Yatekii/projekt5/documentation/report/main.tex

\documentclass{fhnwreport} %
\usepackage[ngerman]{babel}
\usepackage[T1]{fontenc}
\usepackage[utf8x]{inputenc}
\usepackage{tikz}
\usepackage{amsmath}
\usetikzlibrary{arrows}
\usepackage{lmodern}      % Type1-Schriftart für nicht-englische Texte
\usepackage{float}
\usetikzlibrary{shapes}
\usetikzlibrary{intersections}
\usepackage{circuitikz}
\usepackage{transparent}
\usepackage{graphicx}
\usepackage{caption}
\usepackage{subcaption}
\usepackage[toc,page]{appendix}
\usepackage{pdfpages}
\usepackage{siunitx}
\usepackage{mathtools,amssymb}

%%% IEEE-Style Bibliographie
\bibliographystyle{IEEEtran}

%% Und wenn die Bibliographie im Inhaltsverzeichnis sein soll:
\usepackage[nottoc]{tocbibind}

\title{%
  Projekt 5\\[2ex]
  Software Defined Radio}
\author{%
  Noah Hüsser und Francesco Rovelli}

\begin{document}

% Titel
\maketitle

\vfill

% Titelbild
% (kann man natürlich auch mit Includegraphics machen)
\begin{minipage}{\textwidth}
\begin{center}
\vspace*{5ex}
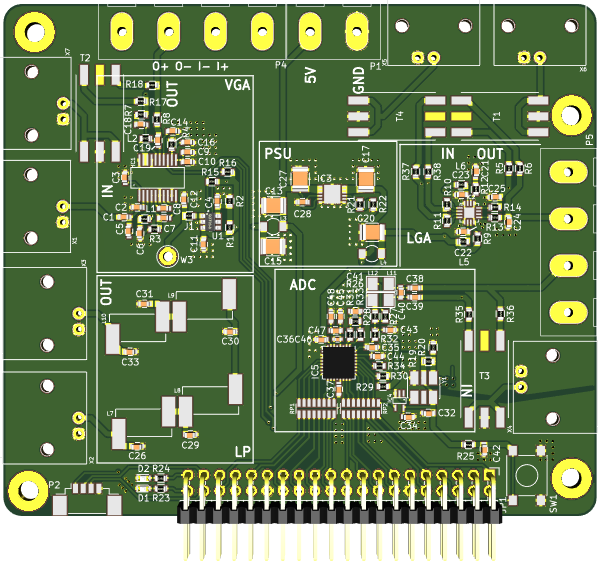
[picture p1: documentation/report/data/images/title.png]
    
\end{center}
\end{minipage}

\vfill

\begin{tabbing}
Auftraggeber: \hspace{2em} \=  Prof. Dr. Markus Hufschmid \\[2ex]
Betreuer:  \>  Prof. Dr. Markus Hufschmid \\[2ex]
Team:  \> Noah Hüsser \\ 
\> Francesco Rovelli \\[2ex]
Studiengang: \> Elektro- und Informationstechnik
\end{tabbing}

\hbox{}

\clearpage

\abstract{Analoge Frontends für Software Defined Radios sind für die Aufbereitung des analogen Signals zuständig und müssen einer Vielzahl von Anforderungen genügen. Dieses Projekt ist die Fortsetzung des 'Software Defined Radio mit FPGA'-Projekts und beschäftigt sich mit der Optimierung des AFE eines vorgängig existierenden Prototypen. Der Fokus liegt auf  der Filterung und der Verstärkung des Eingangssignals. Durch Anwendung von Techniken aus der Analogtechnik im Platinendesign und bei der Optimierung der Schaltung konnte eine überarbeitete Version entwickelt werden. Anschliessend durchgeführte Messungen bestätigen Verbesserungen in der analogen Signalverarbeitung, allerdings konnte die Aufgabenstellung in den Bereichen Rauschen und Digital-Analog-Wandlung nicht ganz abschliessend bearbeitet werden.}
\clearpage

\tableofcontents
\clearpage

\section{Einleitung}
\label{sec:motivation}
\label{sec:einleitung}
\input{sections/einleitung}

\clearpage

\section{Theorie}
\label{sec:sdr}
\input{sections/sdr}

\clearpage

\section{Ausgangslage}
\label{sec:ausgangslage}
\input{sections/ausgangslage}

\clearpage

\section{Design des Analogen Frontends}
\label{sec:afe}
\input{sections/afe}
\newpage
\subsection{Eingangsfilter}
\label{sec:filter}
\input{sections/filter}

\clearpage

\section{Messungen}
\label{sec:messungen}
\input{sections/messungen}

\clearpage

\section{Resultate}
\label{sec:resultate}
\input{sections/resultate}

\clearpage

\section{Diskussion}
\label{sec:diskussion}
\input{sections/diskussion}

\clearpage
\begin{appendices}

\subsection{Schaltplan}
\subsection{Layout}
\subsection{Stückliste}
\subsection{Projektplan}
\subsection{Projektauftrag}
\subsection{CD}

Die beigelegte CD beinhaltet das Git-Repository, welches folgende Dokumente beinhaltet:
  \begin{itemize}
    \item Schaltpläne\\
    \item Layout\\
    \item Python-Scripts\\
    \item Arduino-Source\\
    \item Datasheets\\
    \item Dieses Dokument
  \end{itemize}
\includepdf[pages=1,fitpaper]{data/images/amplifier}

\begin{figure}[H]
\begin{center}
  
  \caption{Top Layout.}
  \label{fig:top}
\end{center}
\end{figure}

\begin{figure}[H]
\begin{center}
  
  \caption{Bottom Layout.}
  \label{fig:bot}
\end{center}
\end{figure}

\includepdf[pages=1,fitpaper]{../../management/bom-prototype}

\includepdf[pages={1},fitpaper]{../../management/tasks}

\includepdf[pages={1,2,3,4},fitpaper]{../../management/Aufgabenstellung_SDR}

\end{appendices}

\clearpage
\bibliography{main,example,IEEEabrv}

\clearpage
\listoffigures

\end{document}
