Yatekii/projekt5/math/input_Z_A8331.png

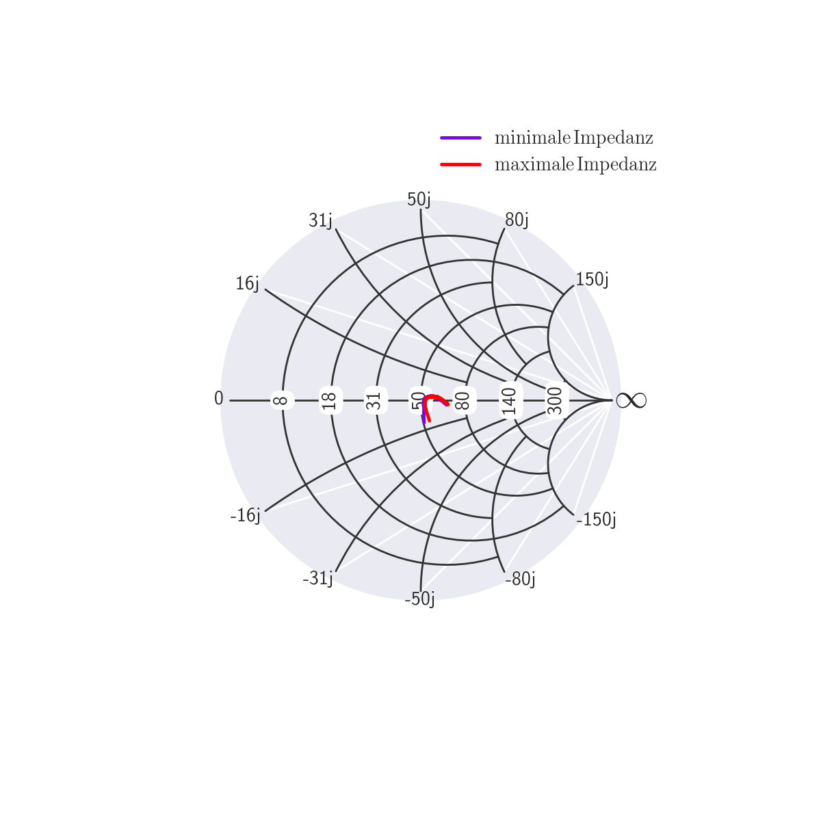
math/input_Z_A8331.png
