Yatekii/projekt5/math/vga_2016-12-16_30dBm_transmission.png

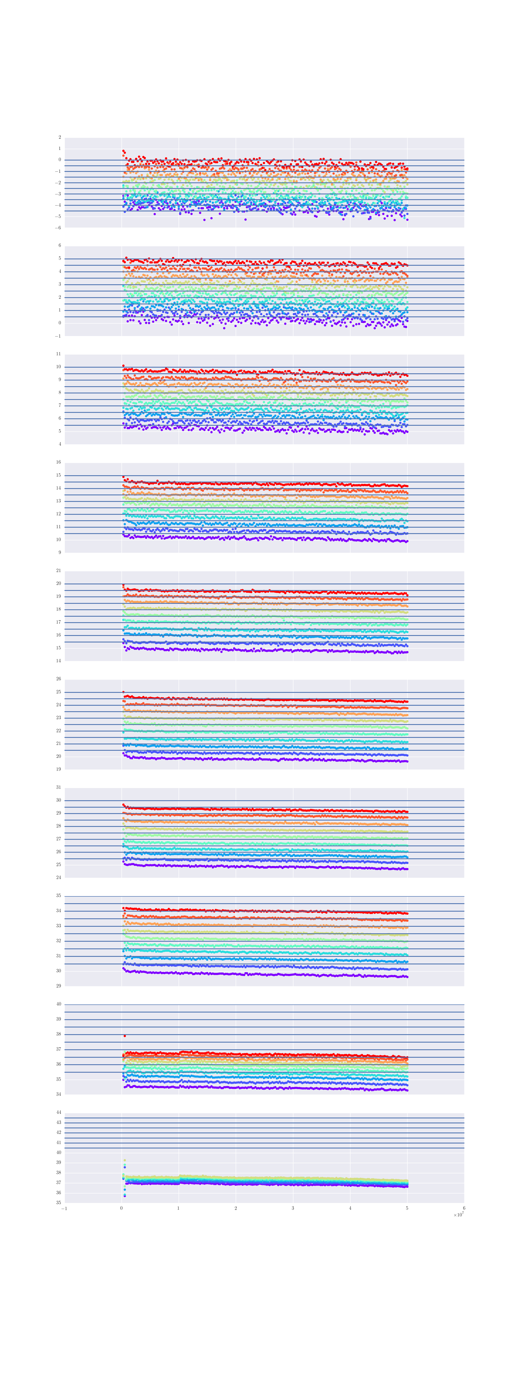
math/vga_2016-12-16_30dBm_transmission.png
