Yatekii/projekt5/math/vga_2016-12-16_40dBm_LNA_transmission.png

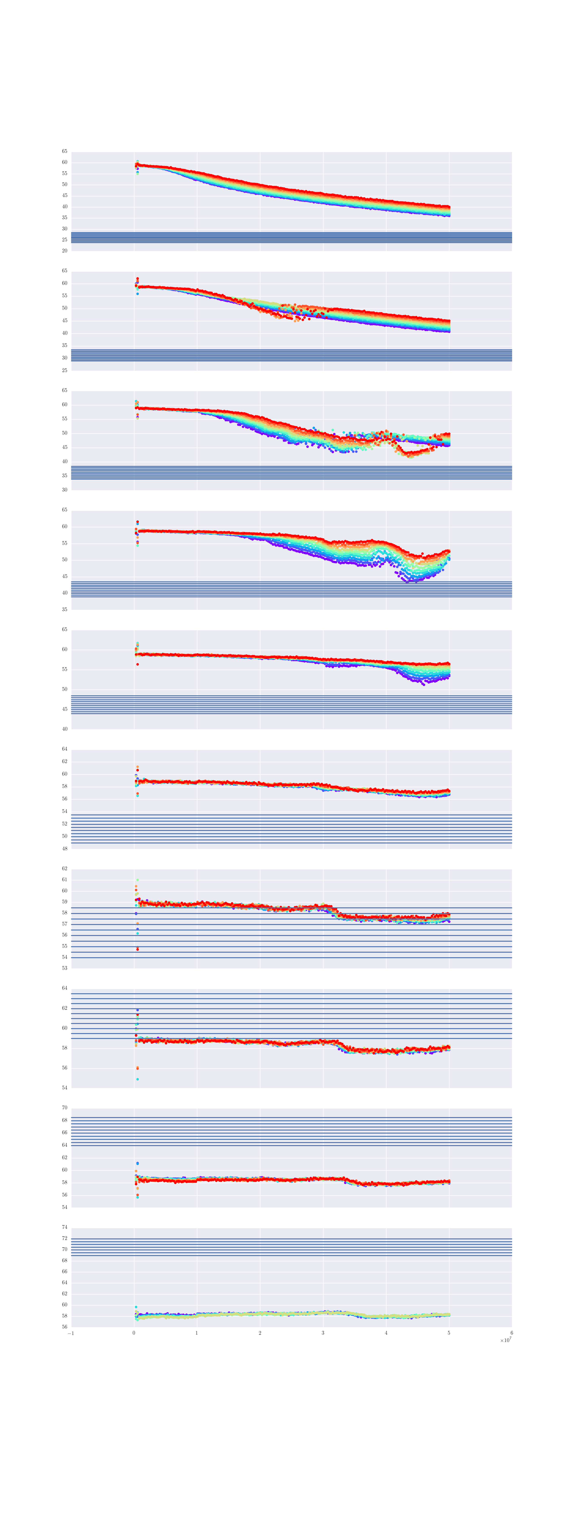
math/vga_2016-12-16_40dBm_LNA_transmission.png
