Yatekii/projekt5/math/vga_2016-12-19_40dBm_20kP_transmission.png

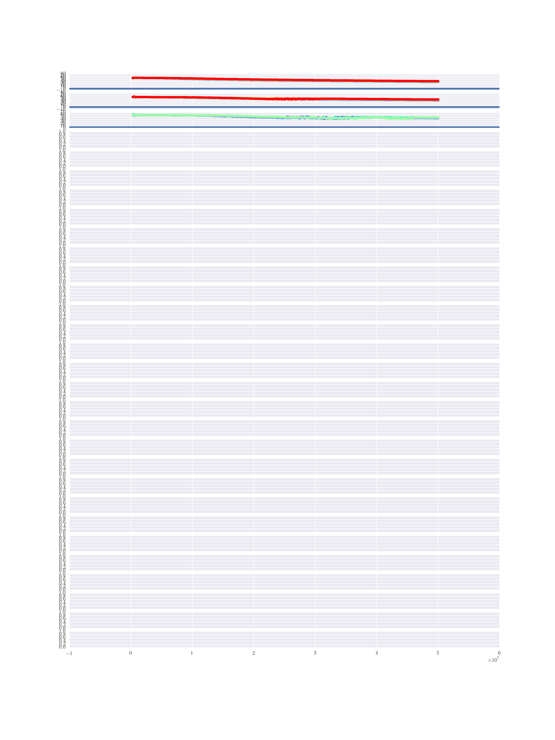
math/vga_2016-12-19_40dBm_20kP_transmission.png
