Yatekii/projekt5/math/vga_2016-12-22_50dBm_LNA_20dB_3_transmission.png

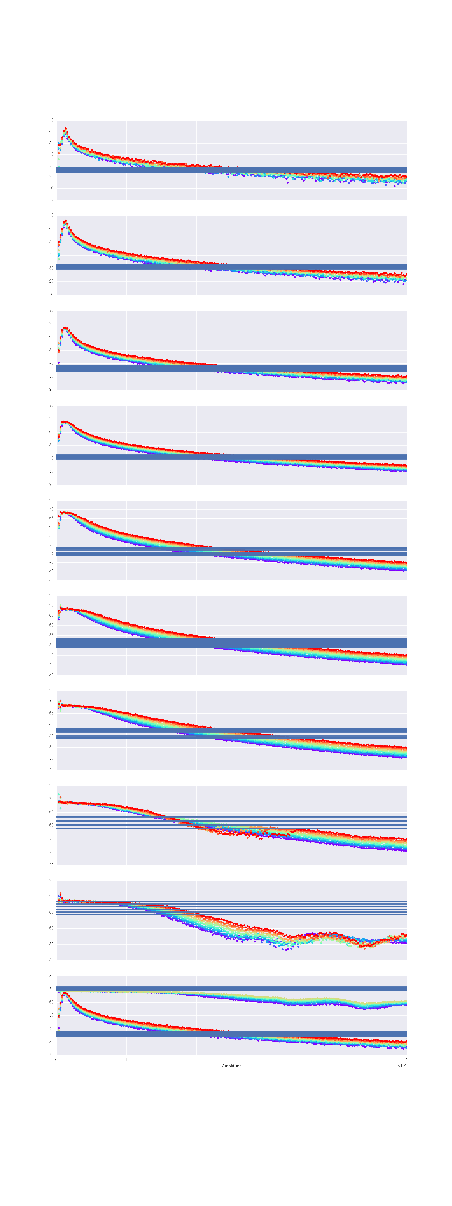
math/vga_2016-12-22_50dBm_LNA_20dB_3_transmission.png
