Yatekii/projekt5/math/vga_2016-12-22_50dBm_LNA_transmission2.png

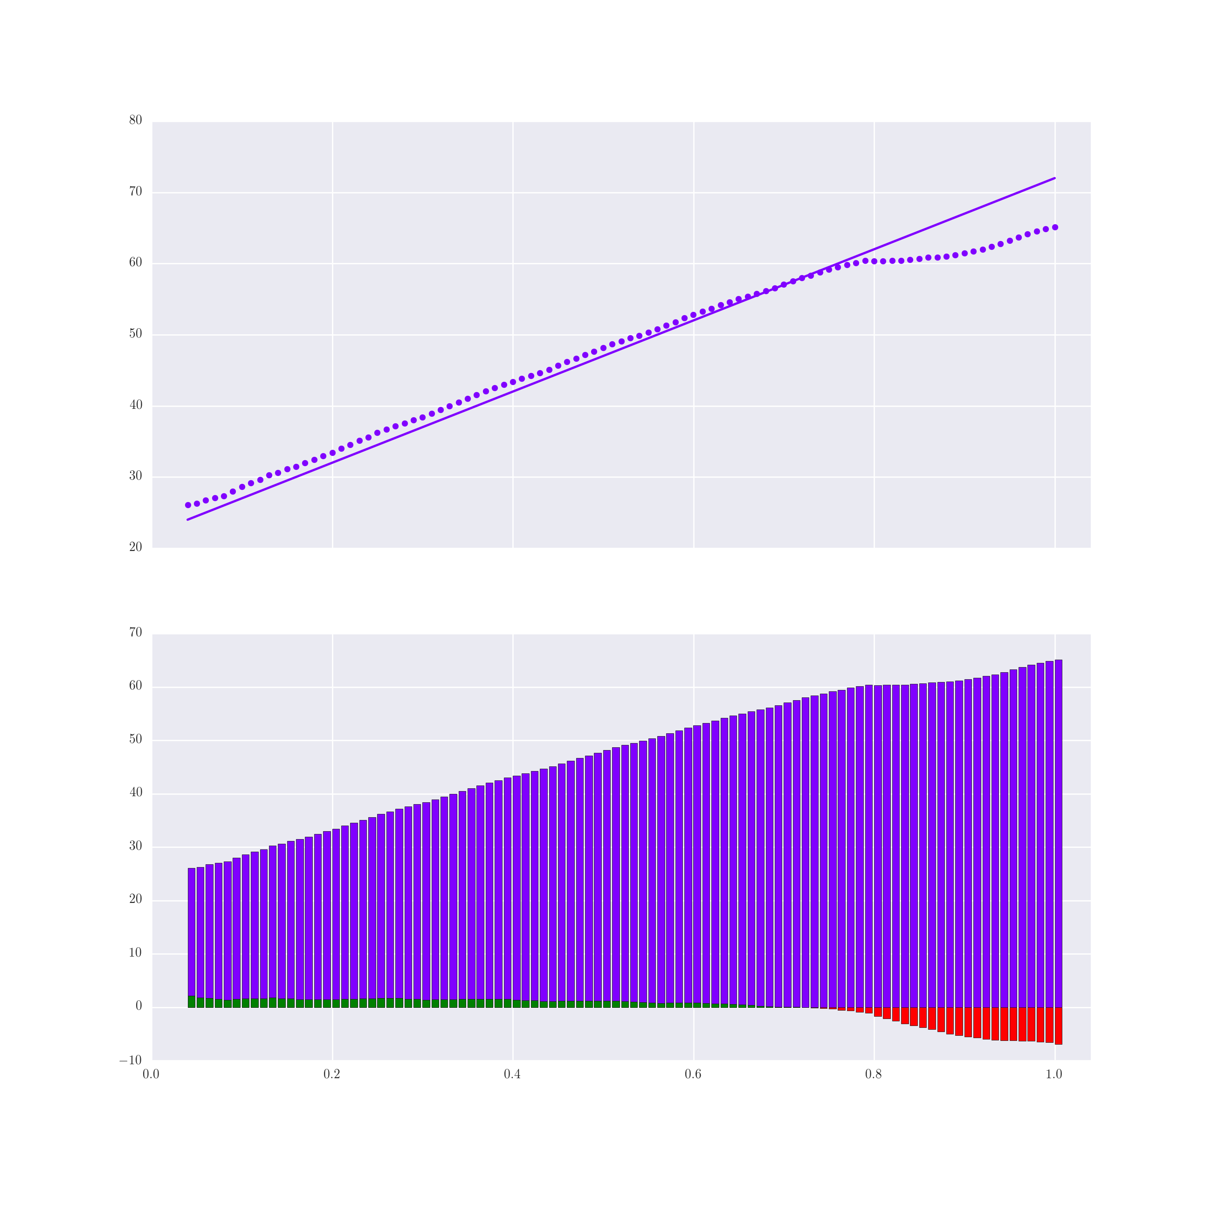
math/vga_2016-12-22_50dBm_LNA_transmission2.png
