Yatekii/projekt5/math/vga_lna_2016-01-18_50dBm_20dB_HI_rez.png

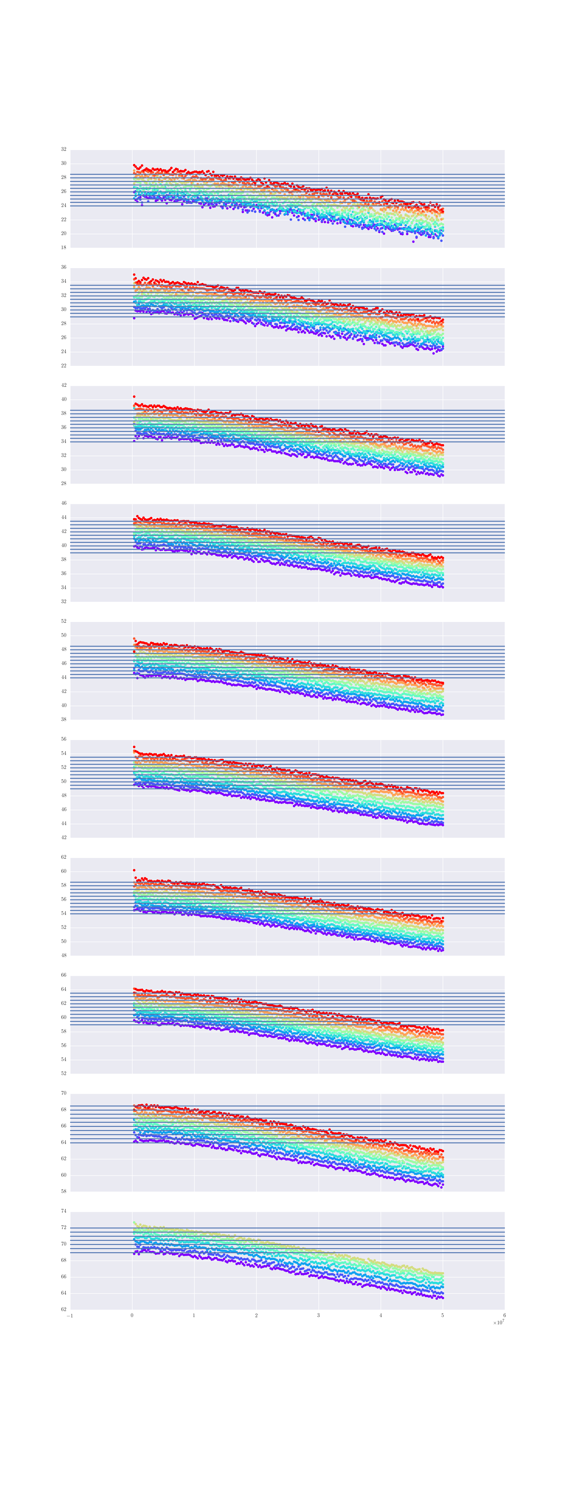
math/vga_lna_2016-01-18_50dBm_20dB_HI_rez.png
