Yatekii/projekt5/management/partslist.txt

4 380nH 2%
4 307nH 2%
7 8.2pF 0603
10 150pF 0603
10 2.2pF 0603
2 22uF 1206
6 100pF 0603
7 15pF 0603
8 10pF 0603
4 100nF 0603
4 1uF 0603
7 18nF 0603
4 82pF 0603
8 22pF 0603
6 180pF 0603
7 10nF 0603
10 Shottky 568-3420-1-ND
2 390nH 490-5698-1-ND
2 22uH 587-1626-1-ND
