Yatekii/projekt5/hardware/documentation/simulation/pifilter/result.txt

1.00000000000000e+000,-1.91051972765979e-003,-3.24650165658417e-004
1.00230523807790e+000,-1.91051896223974e-003,-3.25398561625838e-004
1.00461579027840e+000,-1.91051819328080e-003,-3.26148682794382e-004
1.00693166885180e+000,-1.91051742079550e-003,-3.26900533180799e-004
1.00925288607668e+000,-1.91051664474334e-003,-3.27654116759734e-004
1.01157945425990e+000,-1.91051586510405e-003,-3.28409437533248e-004
1.01391138573668e+000,-1.91051508184678e-003,-3.29166499454556e-004
1.01624869287070e+000,-1.91051429499177e-003,-3.29925306618255e-004
1.01859138805412e+000,-1.91051350448501e-003,-3.30685863056999e-004
1.02093948370768e+000,-1.91051271036702e-003,-3.31448172722033e-004
1.02329299228075e+000,-1.91051191255002e-003,-3.32212239686525e-004
1.02565192625141e+000,-1.91051111106970e-003,-3.32978068033185e-004
1.02801629812647e+000,-1.91051030587011e-003,-3.33745661771645e-004
1.03038612044162e+000,-1.91050949700335e-003,-3.34515024977873e-004
1.03276140576140e+000,-1.91050868435848e-003,-3.35286161776684e-004
1.03514216667934e+000,-1.91050786797216e-003,-3.36059076250408e-004
1.03752841581801e+000,-1.91050704780485e-003,-3.36833772429352e-004
1.03992016582906e+000,-1.91050622386426e-003,-3.37610254493155e-004
1.04231742939330e+000,-1.91050539611663e-003,-3.38388526548381e-004
1.04472021922080e+000,-1.91050456453400e-003,-3.39168592698034e-004
1.04712854805090e+000,-1.91050372916361e-003,-3.39950457027247e-004
1.04954242865232e+000,-1.91050288989745e-003,-3.40734123796689e-004
1.05196187382322e+000,-1.91050204678278e-003,-3.41519597104215e-004
1.05438689639126e+000,-1.91050119973761e-003,-3.42306881151729e-004
1.05681750921366e+000,-1.91050034879859e-003,-3.43095979991423e-004
1.05925372517729e+000,-1.91049949394258e-003,-3.43886897924101e-004
1.06169555719872e+000,-1.91049863513677e-003,-3.44679639149698e-004
1.06414301822431e+000,-1.91049777237732e-003,-3.45474207767283e-004
1.06659612123026e+000,-1.91049690559092e-003,-3.46270608124534e-004
1.06905487922266e+000,-1.91049603485473e-003,-3.47068844334830e-004
1.07151930523761e+000,-1.91049516008676e-003,-3.47868920683907e-004
1.07398941234124e+000,-1.91049428126772e-003,-3.48670841395555e-004
1.07646521362983e+000,-1.91049339839280e-003,-3.49474610696745e-004
1.07894672222983e+000,-1.91049251143112e-003,-3.50280232942729e-004
1.08143395129794e+000,-1.91049162041452e-003,-3.51087712252868e-004
1.08392691402120e+000,-1.91049072527162e-003,-3.51897053071775e-004
1.08642562361706e+000,-1.91048982597445e-003,-3.52708259580378e-004
1.08893009333343e+000,-1.91048892254615e-003,-3.53521336099397e-004
1.09144033644876e+000,-1.91048801493464e-003,-3.54336287004760e-004
1.09395636627209e+000,-1.91048710316404e-003,-3.55153116543732e-004
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
