Yatekii/projekt5/measurements/lowpass_2016_12_02/LOWPASS300K-300M-CONNECTED.PNG

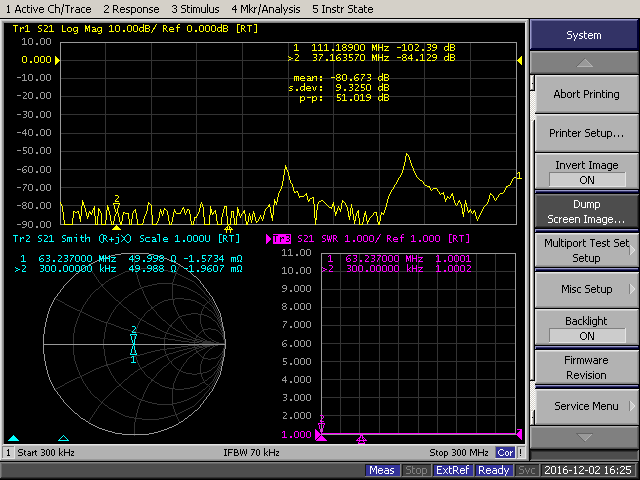
measurements/lowpass_2016_12_02/LOWPASS300K-300M-CONNECTED.PNG
