Yatekii/projekt5/hardware/documentation/simulation/lowpass/lowpass.asc

C1: cap; 82p
C2: cap; 180p
C3: cap; 180p
C4: cap; 180p
C5: cap; 82p
L1: ind; 307n
L2: ind; 380n
L3: ind; 380n
L4: ind; 307n
R1: res; 50
V1: voltage; ""; AC 1 0; Rser=10m
Named nets: 0, Vin, Vout
.ac dec 1000 1MEG 1000MEG
