Yatekii/projekt5/hardware/documentation/simulation/pifilter/p5pifilter.asc

C1: cap; 22µ
C2: cap; 22µ
L1: ind; 22µ
R1: res; 100
V1: voltage; ""; AC 1 0; Rser=10m
Named nets: 0, Vin, Vout
.ac dec 1000 1 1000MEG
