Yatekii/projekt5/hardware/amplifier2/amplifier.kicad_pcb

## KiCad design hardware/amplifier2/amplifier.kicad_pcb (2017-01-19)

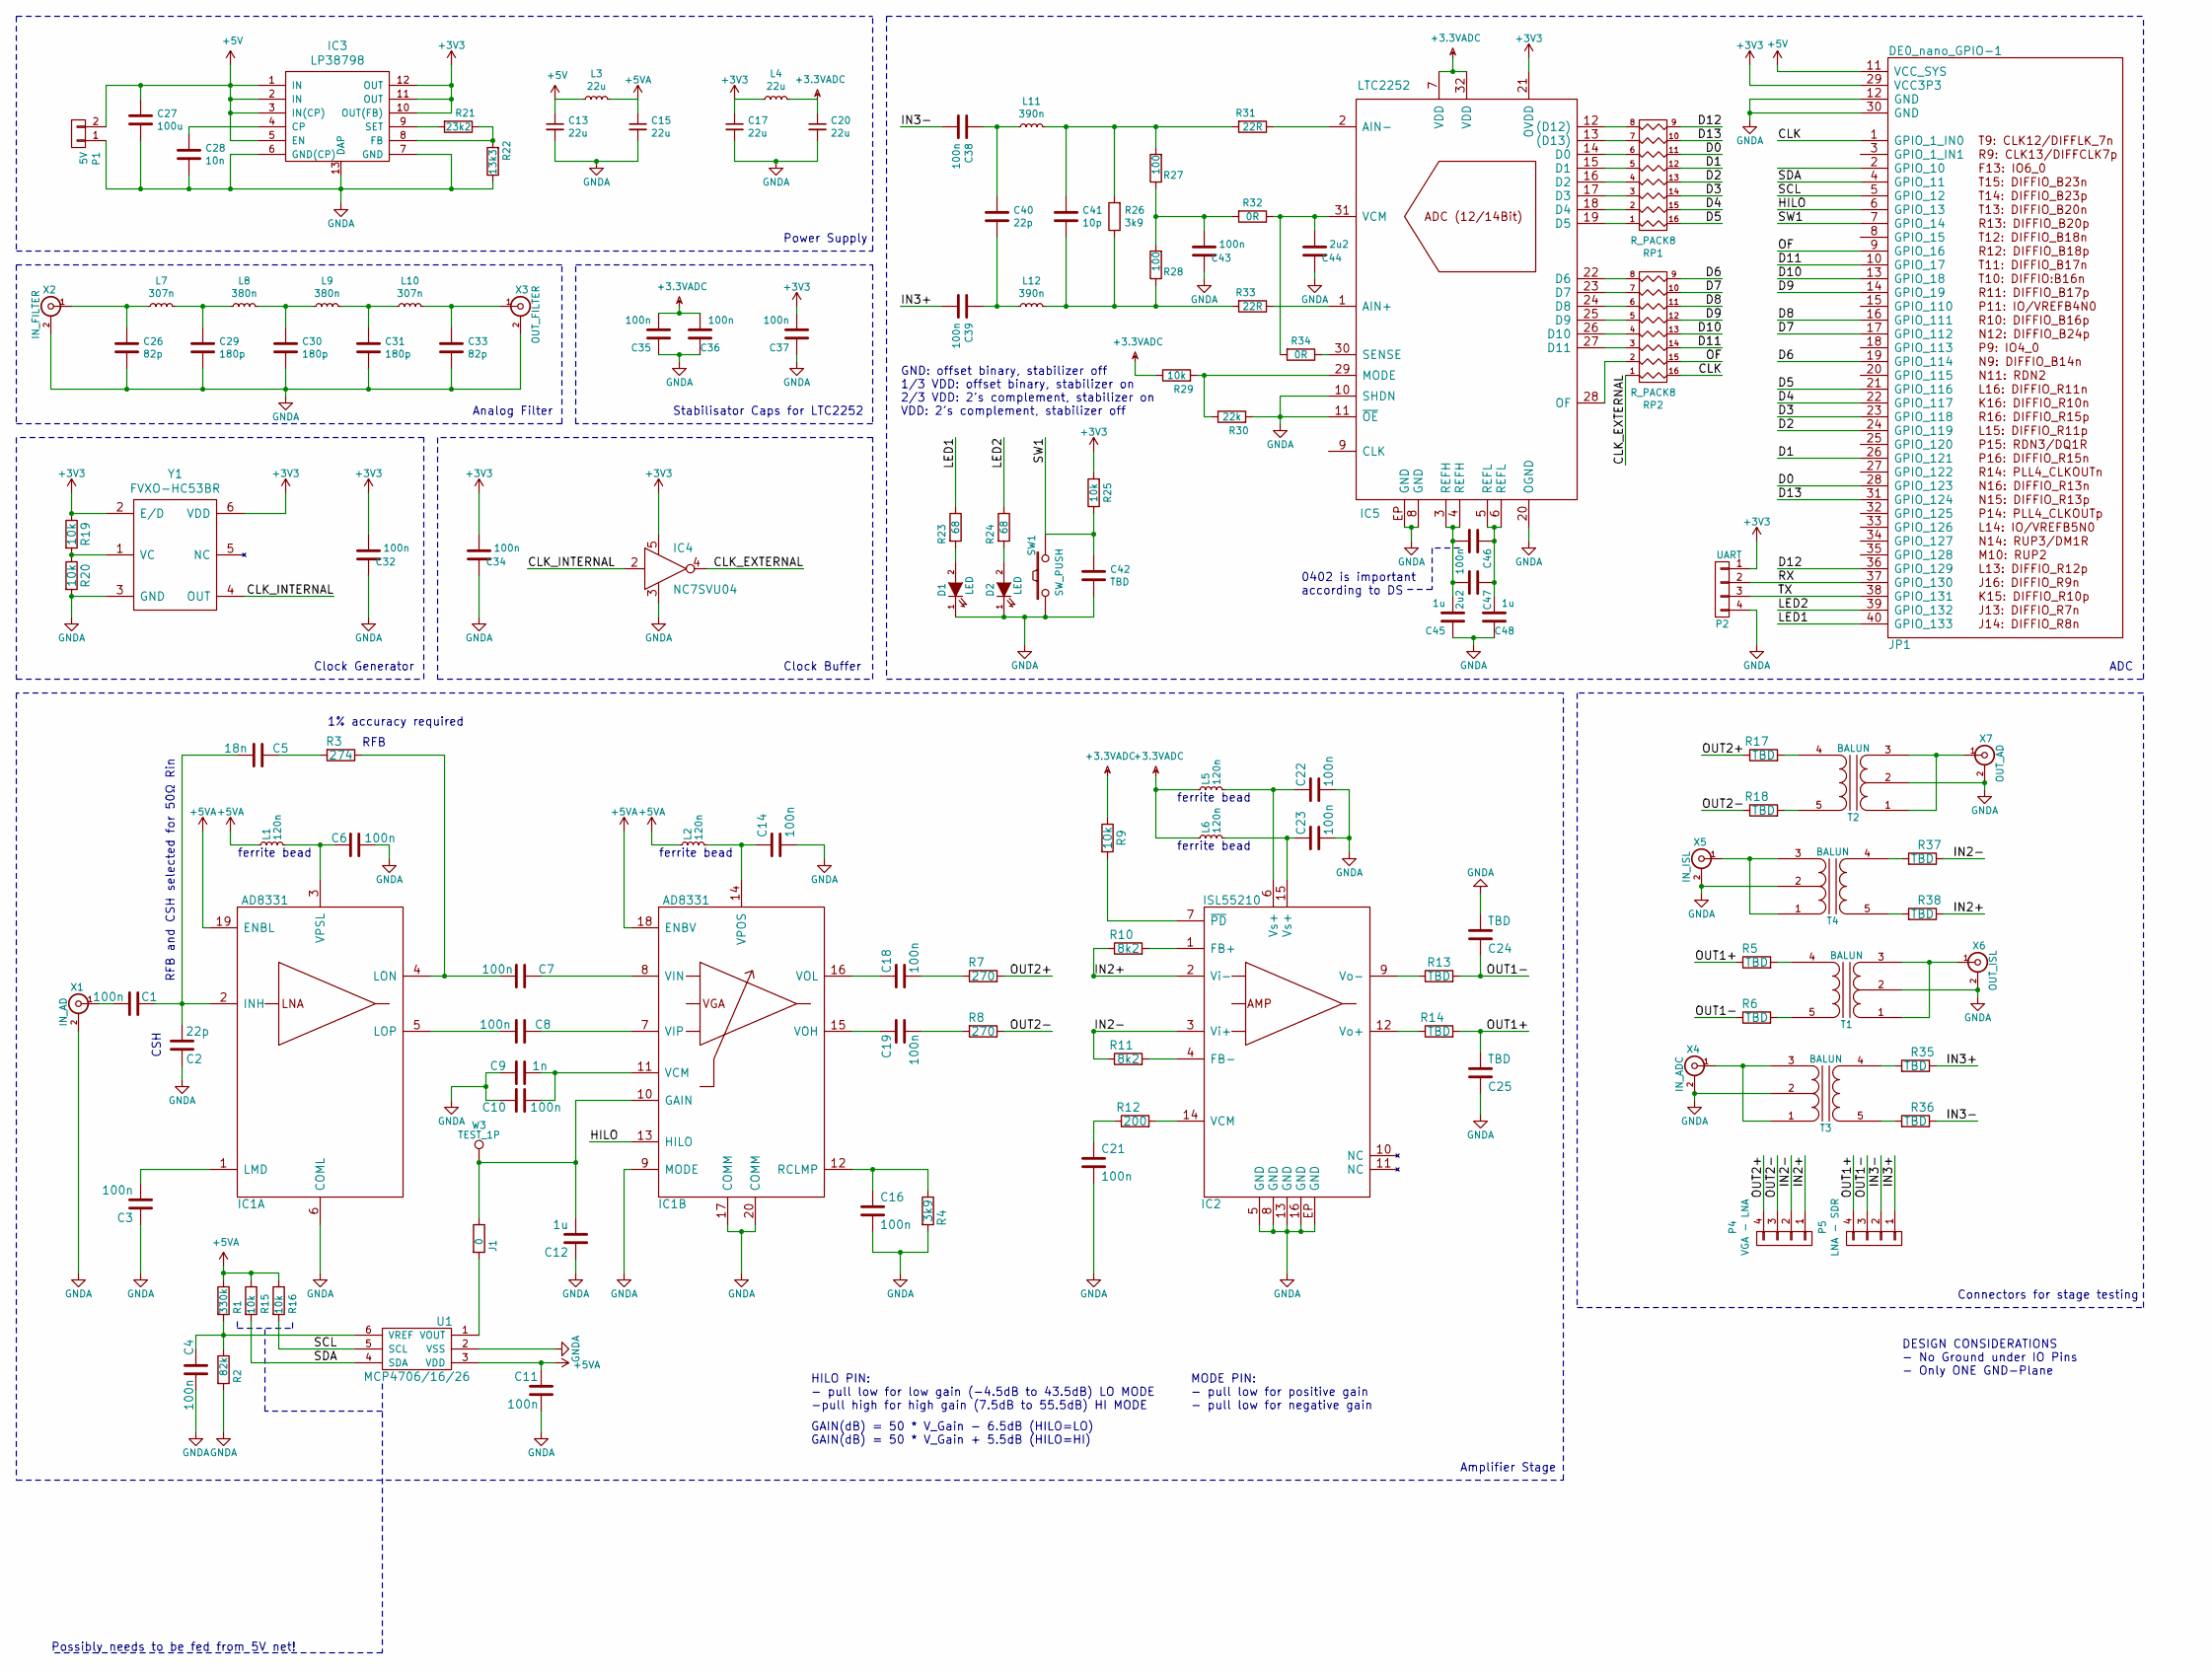
[picture p19: schematic amplifier.sch, Amplifier Stages, part in row 1, column 1]

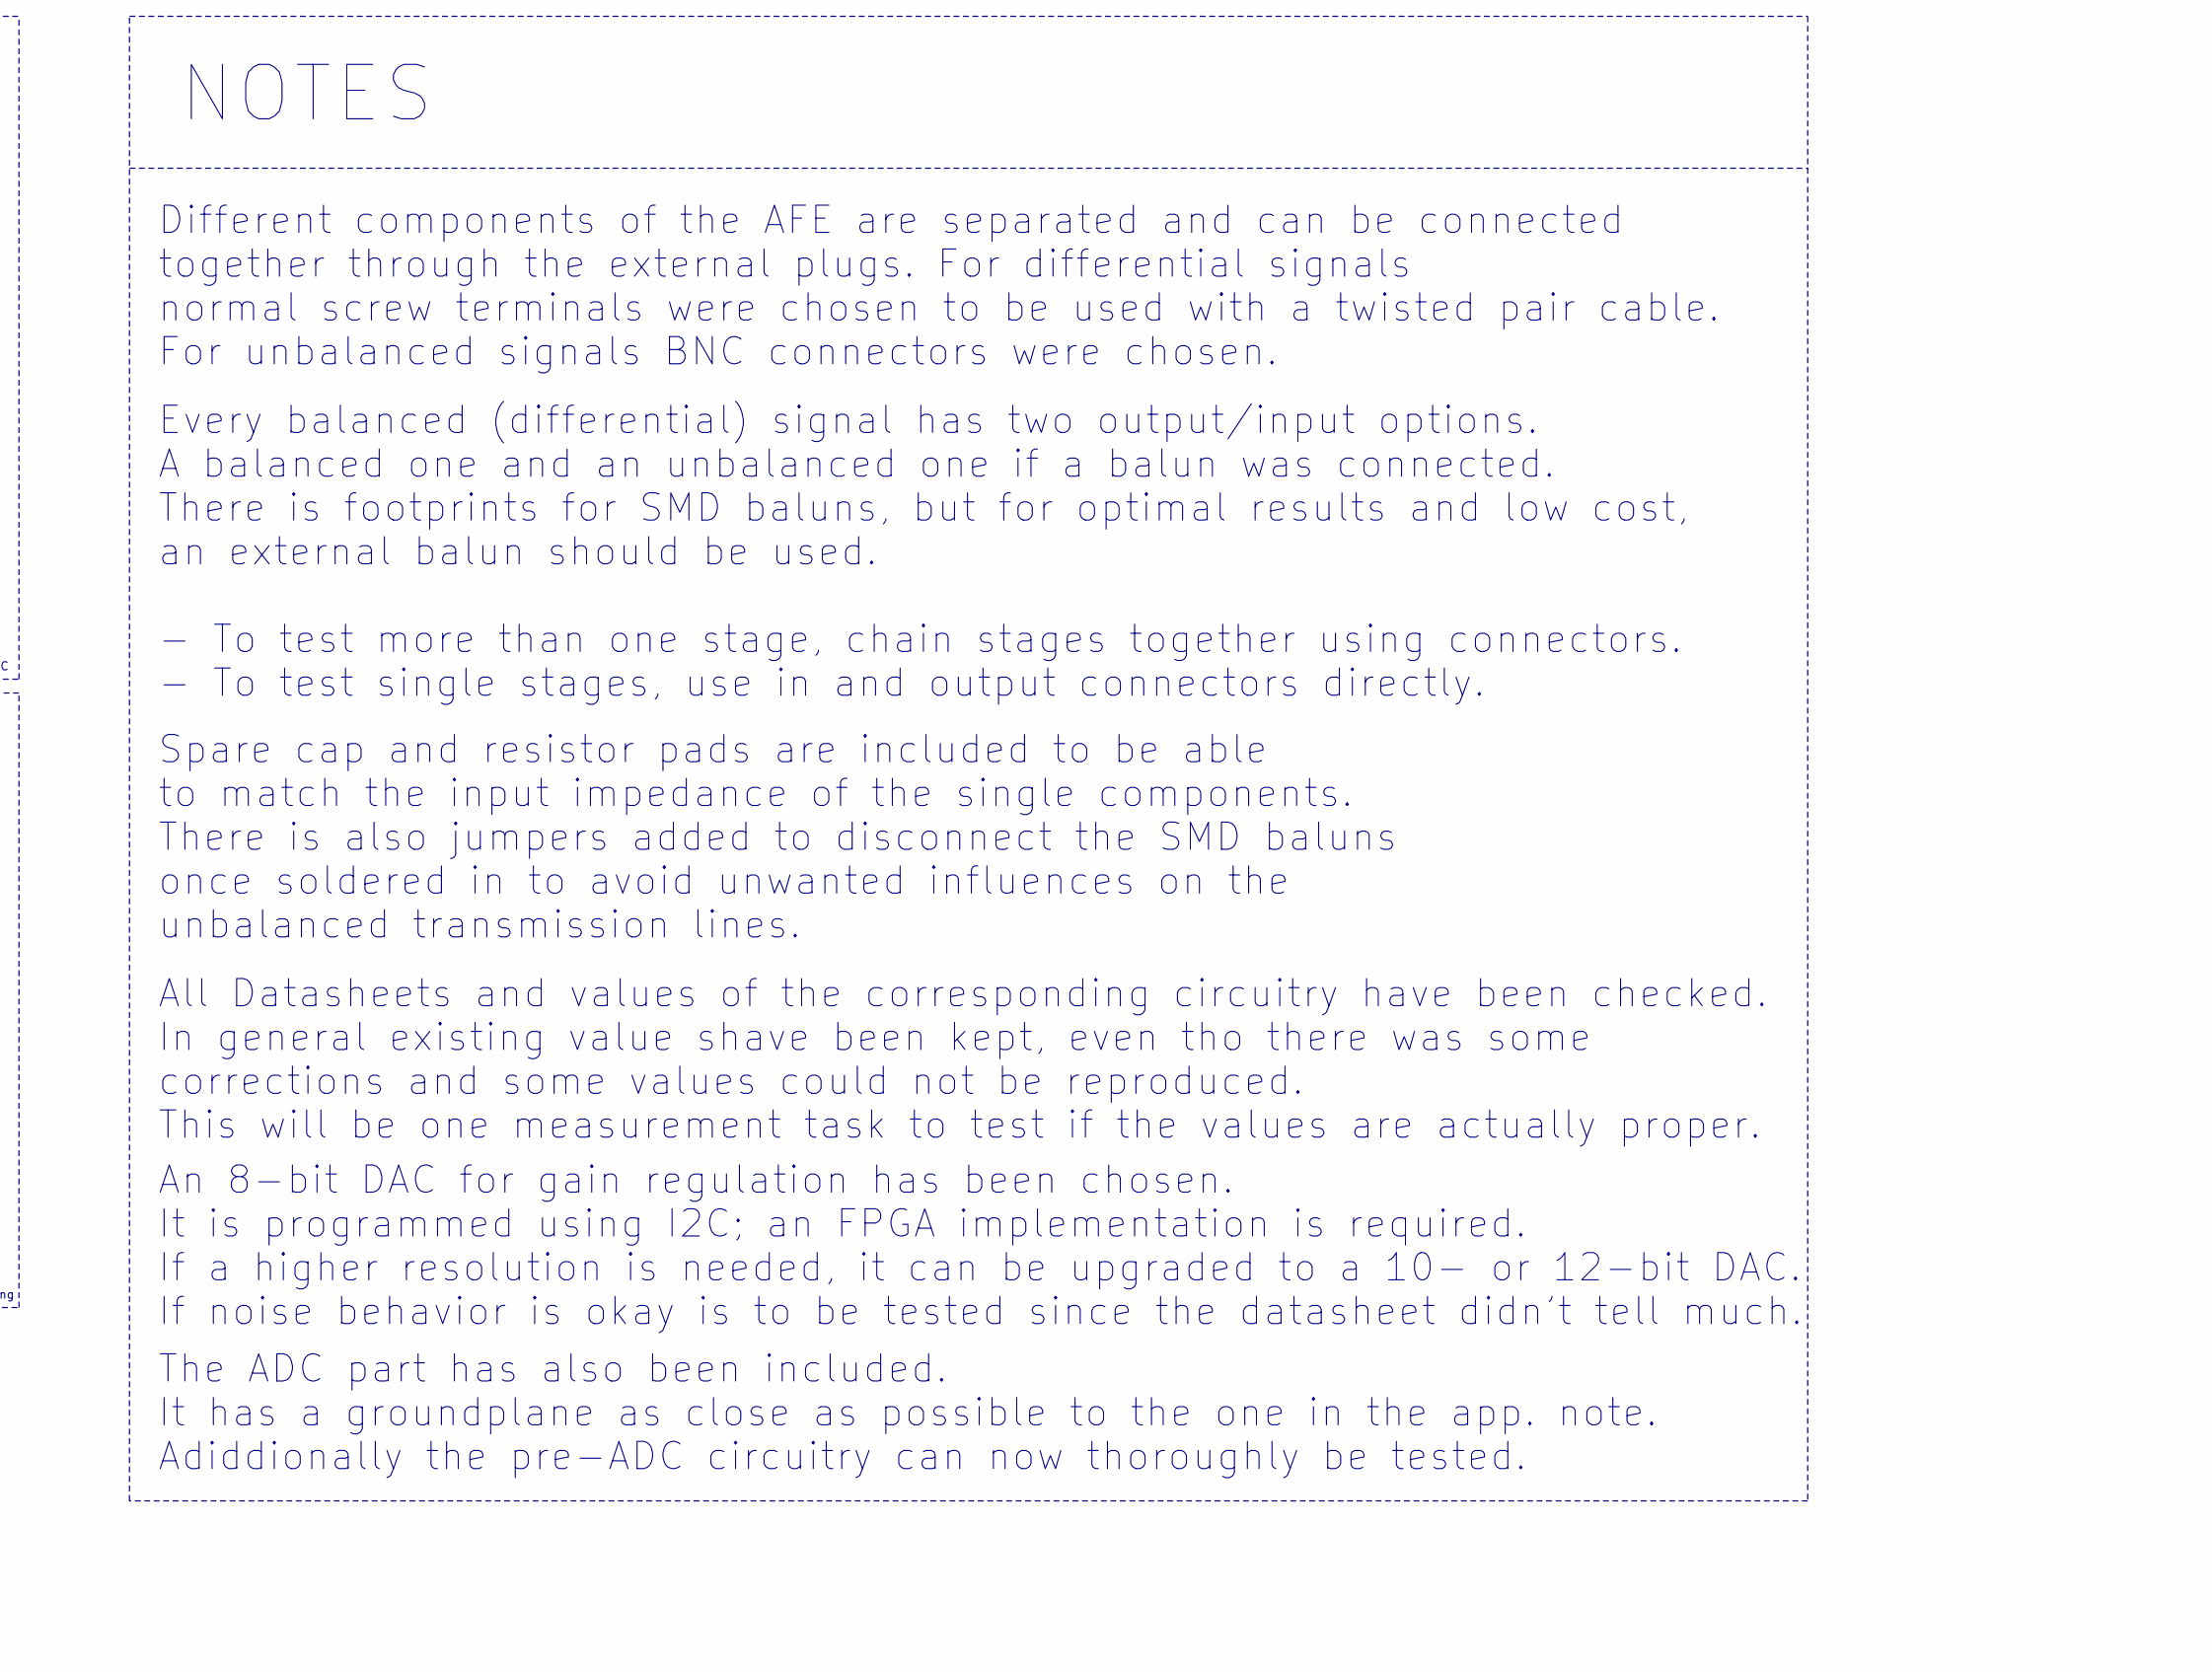
[picture p20: schematic amplifier.sch, Amplifier Stages, part in row 1, column 2]

Parts:
C1, C3, C4, C6, C7, C8, C10, C11, C14, C16, C18, C19, C21, C22, C23, C32, C34, C35, C36, C37, C38, C39, C43: 100n; C_0603
C2, C40: 22p; C_0603
C5: 18n; C_0603
C9: 1n; C_0603
C12, C45, C48: 1u; C_0603
C13, C15, C17, C20: 22u; C_1210
C24, C25, C42: TBD; C_0603
C26, C33: 82p; C_0603
C27: 100u; C_1210
C28: 10n; C_0603
C29, C30, C31: 180p; C_0603
C41: 10p; C_0603
C44, C47: 2u2; C_0603
C46: 100n; C_0402
D1, D2: LED; LED_0603
IC1: AD8331; QSOP20
IC2: ISL55210; TQFN16
IC3: LP38798; WSON12
IC4: NC7SVU04; SOT353
IC5: LTC2252; QFN-32-1EP_5x5mm_Pitch0.5mm
J1: 0; R_0603
JP1: DE0_nano_GPIO-1; Pin_Header_Angled_2x20
L1, L2, L5, L6: 120n; R_0603
L3, L4: 22u; Choke_SMD_1206_Standard
L7, L10: 307n; Coil_132-XXSM_L_
L8, L9: 380n; Coil_132-XXSM_L_
L11, L12: 390n; 1008
P1: 5V; ED365-2
P2: UART; Molex_PicoBlade_53398-0471_04x1.25mm_Straight
P4: VGA - LNA; ED365-4
P5: LNA - SDR; ED365-4
R1: 330k; R_0603
R2: 82k; R_0603
R3: 274; R_0603
R4, R26: 3k9; R_0603
R5, R6, R13, R14, R17, R18, R35, R36, R37, R38: TBD; R_0603
R7, R8: 270; R_0603
R9, R15, R16, R19, R20, R25, R29: 10k; R_0603
R10, R11: 8k2; R_0603
R12: 200; R_0603
R21: 23k2; R_0603
R22: 13k3; R_0603
R23, R24: 68; R_0603
R27, R28: 100; R_0603
R30: 22k; R_0603
R31, R33: 22R; R_0603
R32, R34: 0R; R_0603
RP1, RP2: R_PACK8; 2406
SW1: SW_PUSH; SW_SPST_PTS645
T1, T2, T3, T4: BALUN; T4-1-KK81
U1: MCP4706/16/26; SOT-23-6
W3: TEST_1P; Test_Point_Keystone_5005-5009_Compact
X1: IN_AD; 1-1337543-0
X2: IN_FILTER; 1-1337543-0
X3: OUT_FILTER; 1-1337543-0
X4: IN_ADC; 1-1337543-0
X5: IN_ISL; 1-1337543-0
X6: OUT_ISL; 1-1337543-0
X7: OUT_AD; 1-1337543-0
Y1: FVXO-HC53BR; OSC_631-1265-1-ND

Connections:
+3.3VADC: C20.1, C35.2, C36.2, IC5.7 (VDD), IC5.32 (VDD), L4.2, L5.1, L6.1, R9.1, R29.1
+3V3: C17.1, C32.2, C34.2, C37.2, IC3.10 (OUT(FB)), IC3.11 (OUT), IC3.12 (OUT), IC4.5 (VCC), IC5.21 (OVDD), JP1.29 (VCC3P3), L4.1, P2.1, R19.1, R25.2, Y1.2 (E/D), Y1.6 (VDD)
+5V: C13.1, C27.1, IC3.1 (IN), IC3.2 (IN), IC3.3 (IN(CP)), IC3.5 (EN), JP1.11 (VCC_SYS), L3.1, P1.2
+5VA: C11.1, C15.1, IC1.18 (ENBV), IC1.19 (ENBL), L1.1, L2.1, L3.2, R1.1, R15.1, R16.1, U1.3 (VDD)
/CLK: JP1.1 (GPIO_1_IN0), RP2.16 (R1)
/CLK_EXTERNAL: IC4.4 (Y), RP2.1
/CLK_INTERNAL: IC4.2 (A), Y1.4 (OUT)
/D0: JP1.28 (GPIO_123), RP1.11 (R6)
/D1: JP1.26 (GPIO_121), RP1.12 (R5)
/D2: JP1.24 (GPIO_119), RP1.13 (R4)
/D3: JP1.23 (GPIO_118), RP1.14 (R3)
/D4: JP1.22 (GPIO_117), RP1.15 (R2)
/D5: JP1.21 (GPIO_116), RP1.16 (R1)
/D6: JP1.19 (GPIO_114), RP2.9 (R8)
/D7: JP1.17 (GPIO_112), RP2.10 (R7)
/D8: JP1.16 (GPIO_111), RP2.11 (R6)
/D9: JP1.14 (GPIO_19), RP2.12 (R5)
/D10: JP1.13 (GPIO_18), RP2.13 (R4)
/D11: JP1.10 (GPIO_17), RP2.14 (R3)
/D12: JP1.36 (GPIO_129), RP1.9 (R8)
/D13: JP1.31 (GPIO_124), RP1.10 (R7)
/HILO: IC1.13 (HILO), JP1.6 (GPIO_13)
/IN2+: IC2.2 (Vi-), P4.1, R10.1, R38.1
/IN2-: IC2.3 (Vi+), P4.2, R11.1, R37.1
/IN3+: C39.2, P5.1, R35.1
/IN3-: C38.2, P5.2, R36.1
/LED1: JP1.40 (GPIO_133), R23.1
/LED2: JP1.39 (GPIO_132), R24.1
/OF: JP1.9 (GPIO_16), RP2.15 (R2)
/OUT1+: C25.1, P5.4, R5.1, R14.2
/OUT1-: C24.2, P5.3, R6.1, R13.2
/OUT2+: P4.4, R7.2, R17.1
/OUT2-: P4.3, R8.1, R18.1
/RX: JP1.37 (GPIO_130), P2.2
/SCL: JP1.5 (GPIO_12), R16.2, U1.5 (SCL)
/SDA: JP1.4 (GPIO_11), R15.2, U1.4 (SDA)
/SW1: C42.1, JP1.7 (GPIO_14), R25.1, SW1.2
/TX: JP1.38 (GPIO_131), P2.3
GNDA: C2.1, C3.1, C4.2, C6.2, C9.1, C10.1, C11.2, C12.1, C13.2, C14.2, C15.2, C16.2, C17.2, C20.2, C21.2, C22.1, C23.1, C24.1, C25.2, C26.2, C27.2, C28.2, C29.2, C30.2, C31.2, C32.1, C33.2, C34.1, C35.1, C36.1, C37.1, C42.2, C43.1, C44.1, C45.1, C48.1, D1.1 (K), D2.1 (K), IC1.6 (COML), IC1.9 (MODE), IC1.17 (COMM), IC1.20 (COMM), IC2.5 (GND), IC2.8 (GND), IC2.13 (GND), IC2.16 (GND), IC2.EP (GND), IC3.6 (GND(CP)), IC3.7 (GND), IC3.13 (DAP), IC4.3 (GND), IC5.8 (GND), IC5.10 (SHDN), IC5.11 (~OE), IC5.20 (OGND), IC5.EP (GND), JP1.12 (GND), JP1.30 (GND), P1.1, P2.4, R2.2, R4.2, R20.2, R22.1, R30.2, SW1.1, T1.2 (PM), T2.2 (PM), T3.2 (PM), T4.2 (PM), U1.2 (VSS), X1.2 (Ext), X2.2 (Ext), X3.2 (Ext), X4.2 (Ext), X5.2 (Ext), X6.2 (Ext), X7.2 (Ext), Y1.3 (GND)
unnamed: C1.1, C2.2, C5.2, IC1.2 (INH)
unnamed: C1.2, X1.1 (In)
unnamed: C3.2, IC1.1 (LMD)
unnamed: C4.1, R1.2, R2.1, U1.6 (VREF)
unnamed: C5.1, R3.2
unnamed: C6.1, IC1.3 (VPSL), L1.2
unnamed: C7.1, IC1.4 (LON), R3.1
unnamed: C7.2, IC1.8 (VIN)
unnamed: C8.1, IC1.7 (VIP)
unnamed: C8.2, IC1.5 (LOP)
unnamed: C9.2, C10.2, IC1.11 (VCM)
unnamed: C12.2, IC1.10 (GAIN), J1.1, W3.1
unnamed: C14.1, IC1.14 (VPOS), L2.2
unnamed: C16.1, IC1.12 (RCLMP), R4.1
unnamed: C18.1, IC1.16 (VOL)
unnamed: C18.2, R7.1
unnamed: C19.1, IC1.15 (VOH)
unnamed: C19.2, R8.2
unnamed: C21.1, R12.1
unnamed: C22.2, IC2.6 (Vs+), L5.2
unnamed: C23.2, IC2.15 (Vs+), L6.2
unnamed: C26.1, L7.1, X2.1 (In)
unnamed: C28.1, IC3.4 (CP)
unnamed: C29.1, L7.2, L8.1
unnamed: C30.1, L8.2, L9.1
unnamed: C31.1, L9.2, L10.1
unnamed: C33.1, L10.2, X3.1 (In)
unnamed: C38.1, C40.1, L11.1
unnamed: C39.1, C40.2, L12.1
unnamed: C41.1, L11.2, R26.2, R27.2, R31.2
unnamed: C41.2, L12.2, R26.1, R28.1, R33.2
unnamed: C43.2, R27.1, R28.2, R32.2
unnamed: C44.2, IC5.31 (VCM), R32.1, R34.2
unnamed: C45.2, C46.2, C47.2, IC5.3 (REFH), IC5.4 (REFH)
unnamed: C46.1, C47.1, C48.2, IC5.5 (REFL), IC5.6 (REFL)
unnamed: D1.2 (A), R23.2
unnamed: D2.2 (A), R24.2
unnamed: IC2.1 (FB+), R10.2
unnamed: IC2.4 (FB-), R11.2
unnamed: IC2.7 (~PD), R9.2
unnamed: IC2.9 (Vo-), R13.1
unnamed: IC2.12 (Vo+), R14.1
unnamed: IC2.14 (VCM), R12.2
unnamed: IC3.8 (FB), R21.1, R22.2
unnamed: IC3.9 (SET), R21.2
unnamed: IC5.1 (AIN+), R33.1
unnamed: IC5.2 (AIN-), R31.1
unnamed: IC5.12 ((D12)), RP1.8
unnamed: IC5.13 ((D13)), RP1.7
unnamed: IC5.14 (D0), RP1.6
unnamed: IC5.15 (D1), RP1.5
unnamed: IC5.16 (D2), RP1.4
unnamed: IC5.17 (D3), RP1.3
unnamed: IC5.18 (D4), RP1.2
unnamed: IC5.19 (D5), RP1.1
unnamed: IC5.22 (D6), RP2.8
unnamed: IC5.23 (D7), RP2.7
unnamed: IC5.24 (D8), RP2.6
unnamed: IC5.25 (D9), RP2.5
unnamed: IC5.26 (D10), RP2.4
unnamed: IC5.27 (D11), RP2.3
unnamed: IC5.28 (OF), RP2.2
unnamed: IC5.29 (MODE), R29.2, R30.1
unnamed: IC5.30 (SENSE), R34.1
unnamed: J1.2, U1.1 (VOUT)
unnamed: R5.2, T1.4 (S1)
unnamed: R6.2, T1.5 (S2)
unnamed: R17.2, T2.4 (S1)
unnamed: R18.2, T2.5 (S2)
unnamed: R19.2, R20.1, Y1.1 (VC)
unnamed: R35.2, T3.4 (S1)
unnamed: R36.2, T3.5 (S2)
unnamed: R37.2, T4.4 (S1)
unnamed: R38.2, T4.5 (S2)
unnamed: T1.1 (PR1), T1.3 (PR2), X6.1 (In)
unnamed: T2.1 (PR1), T2.3 (PR2), X7.1 (In)
unnamed: T3.1 (PR1), T3.3 (PR2), X4.1 (In)
unnamed: T4.1 (PR1), T4.3 (PR2), X5.1 (In)

Notes on the sheet:
MODE PIN: - pull low for positive gain - pull low for negative gain
HILO PIN: - pull low for low gain (-4.5dB to 43.5dB) LO MODE -pull high for high gain (7.5dB to 55.5dB) HI MODE
GAIN(dB) = 50 * V_Gain - 6.5dB (HILO=LO) GAIN(dB) = 50 * V_Gain + 5.5dB (HILO=HI)
1% accuracy required
RFB and CSH selected for 50Ω Rin
CSH
RFB
DESIGN CONSIDERATIONS - No Ground under IO Pins - Only ONE GND-Plane
ferrite bead
Power Supply
Amplifier Stage
Analog Filter
Clock Generator
Clock Buffer
0402 is important according to DS
Stabilisator Caps for LTC2252
GND: offset binary, stabilizer off 1/3 VDD: offset binary, stabilizer on 2/3 VDD: 2’s complement, stabilizer on VDD: 2’s complement, stabilizer off
Connectors for stage testing
ADC
Different components of the AFE are separated and can be connected together through the external plugs. For differential signals normal screw terminals were chosen to be used with a twisted pair cable. For unbalanced signals BNC connectors were chosen.
Every balanced (differential) signal has two output/input options. A balanced one and an unbalanced one if a balun was connected. There is footprints for SMD baluns, but for optimal results and low cost, an external balun should be used. - To test more than one stage, chain stages together using co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
Spare cap and resistor pads are included to be able to match the input impedance of the single components. There is also jumpers added to disconnect the SMD baluns once soldered in to avoid unwanted influences on the unbalanced transmission lines.
NOTES
All Datasheets and values of the corresponding circuitry have been checked. In general existing value shave been kept, even tho there was some corrections and some values could not be reproduced. This will be one measurement task to test if the values are actually proper.
An 8-bit DAC for gain regulation has been chosen. It is programmed using I2C; an FPGA implementation is required. If a higher resolution is needed, it can be upgraded to a 10- or 12-bit DAC. If noise behavior is okay is to be tested since the datasheet didn’t tell much.
The ADC part has also been included. It has a groundplane as close as possible to the one in the app. note. Adiddionally the pre-ADC circuitry can now thoroughly be tested.
Possibly needs to be fed from 5V net!

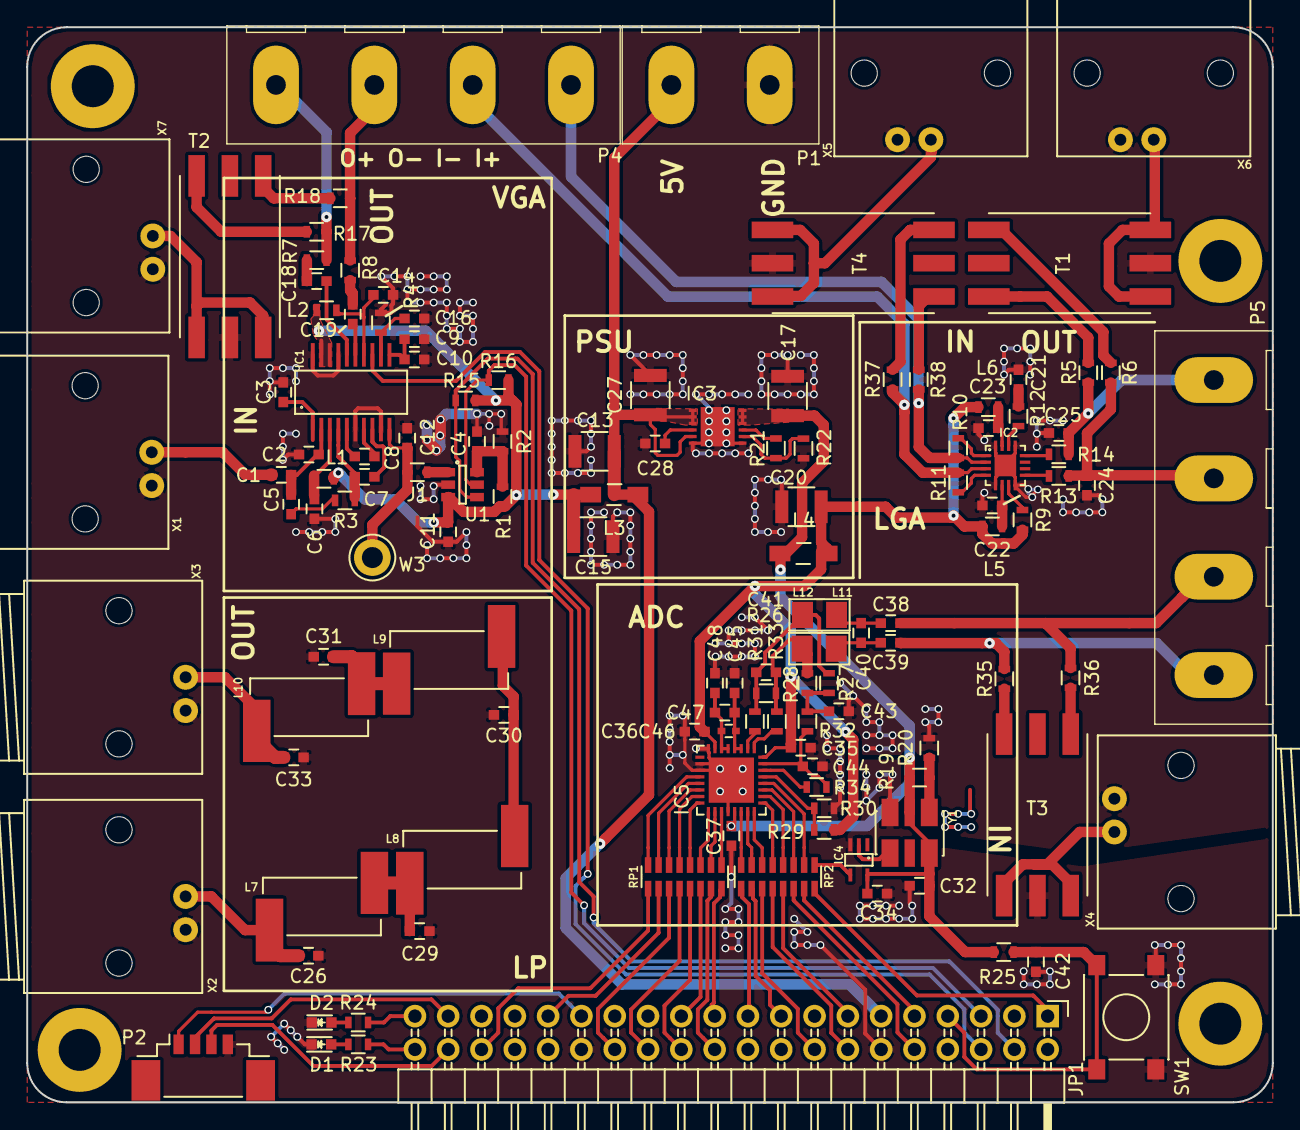
[picture p21: board amplifier.kicad_pcb from above]

Board: 2 copper layers, 95.0 x 82.0 mm, 132 parts (0 on the bottom side), 117 nets.

Other parts of the board:
M1, M2, M3, M4: MountingHole_3.2mm_M3_Pad
