Yatekii/projekt5/hardware/lowpass/lowpass.kicad_pcb

## KiCad design hardware/lowpass/lowpass.kicad_pcb (2016-10-27)

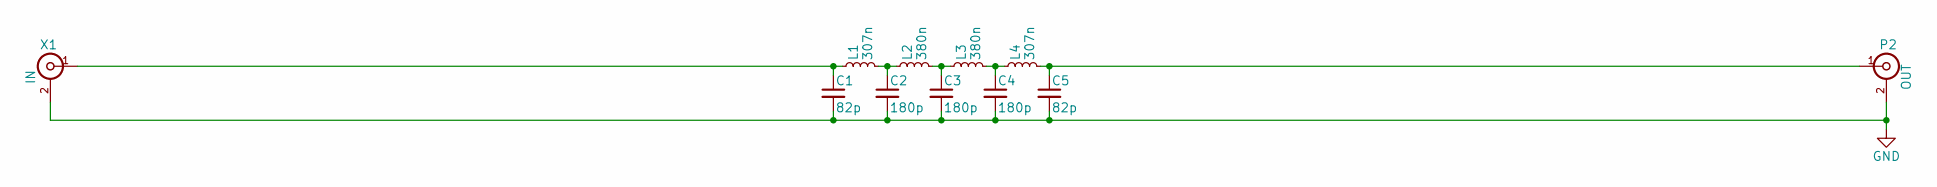
[picture p22: schematic lowpass.sch]

Parts:
C1, C5: 82p; C_0603_HandSoldering
C2, C3, C4: 180p; C_0603_HandSoldering
L1, L4: 307n
L2, L3: 380n
P2: OUT; 1-1337543-0
X1: IN; 1-1337543-0

Connections:
GND: C1.2, C2.2, C3.2, C4.2, C5.2, P2.2 (Ext), X1.2 (Ext)
unnamed: C1.1, L1.1, X1.1 (In)
unnamed: C2.1, L1.2, L2.1
unnamed: C3.1, L2.2, L3.1
unnamed: C4.1, L3.2, L4.1
unnamed: C5.1, L4.2, P2.1 (In)

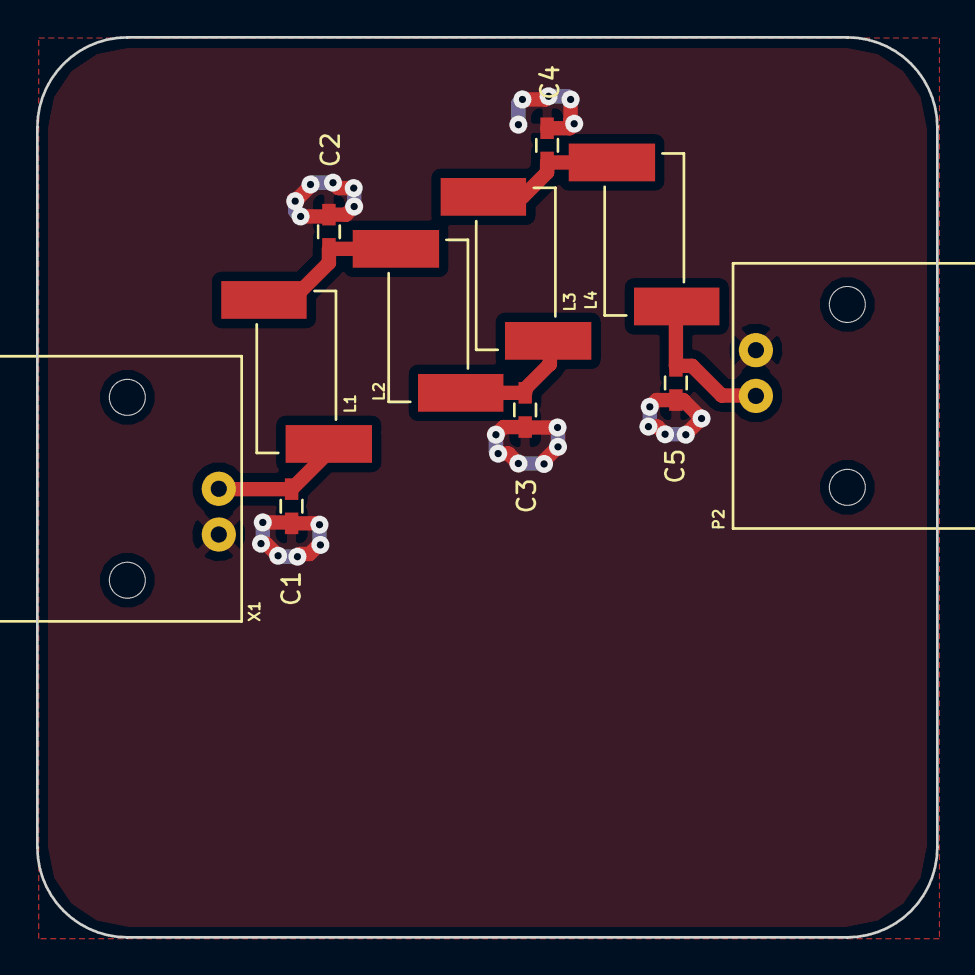
[picture p23: board lowpass.kicad_pcb from above]

Board: 2 copper layers, 50.0 x 50.0 mm, 11 parts (0 on the bottom side), 6 nets.
