Yatekii/projekt5/(commit log)

2016-10-10 added template for kicad
    [template.kicad_pcb, template.sch]
2016-10-10 added rough time estimate; added datasheets
    [tasks.xlsx]
2016-10-15 Amp schema done
    [amplifier.kicad_pcb, amplifier.sch]
2016-10-15 Worked on amp schema; nearly done; ISL55210 needs review as well as output termination
    [amplifier.sch]
2016-10-15 schema done for now; needs some minor changes; routing done for this schema
    [amplifier.kicad_pcb, amplifier.sch]
2016-10-18 Added lowpass simulation and schematic
    [lowpass.kicad_pcb, lowpass.sch]
2016-10-19 first version of filter layout
    [lowpass.kicad_pcb]
2016-10-27 amp done
    [amplifier.kicad_pcb, amplifier.sch]
2016-10-27 Amp PCB completely done with power taps and baluns
    [amplifier.kicad_pcb, amplifier.sch]
2016-10-27 Fixed long traces in lowpass
    [lowpass.kicad_pcb]
2016-10-28 Added first version of powersupply schematic including datasheet
    [powersupply.kicad_pcb, powersupply.sch]
2016-11-10 wip noah
    [amplifier.kicad_pcb, amplifier.sch]
2016-11-10 joined all schemas; added ADC stage; needs footprint assignments and layout
    [amplifier.sch]
2016-11-10 rerouting nearly done; added remaining footprints
    [amplifier.kicad_pcb, amplifier.sch]
2016-11-10 last state; minor changes still to do; powersupply missing; outline missing
    [amplifier.kicad_pcb, amplifier.sch]
2016-11-10 all routing but PSU done; maybe schema needs nicer annotations
    [amplifier.kicad_pcb, amplifier.sch]
2016-11-12 Updated and placed LDO, added wip bom. routing is wip
    [amplifier.kicad_pcb, amplifier.sch, bom-prototype.xlsx]
2016-11-12 Fixed the mess caused by rescue libraries
    [amplifier.sch, bom-prototype.xlsx]
2016-11-12 Routed LDO, updated LED resistors, added resistor part numbers
    [amplifier.kicad_pcb, amplifier.sch, bom-prototype.xlsx]
2016-11-13 everything done routing; removed obsolete testpins; needs groundplane checks and stitchings; needs mounting holes; maybe elaborate in schema
    [amplifier.kicad_pcb, amplifier.sch]
2016-11-13 checked groundplane; added ground viastitching where necessary; added slits in groundplane where necessary; added mounting holes; adjusted silkscreen; adjusted board outline
    [amplifier.kicad_pcb]
2016-11-13 updated bom to fit
    [bom-prototype.xlsx]
2016-11-13 styled bom
    [bom-prototype.xlsx]
2016-11-13 Added notes to schematic explaining some of the features; Adjusted dimension markers of the board
    [amplifier.kicad_pcb, amplifier.sch]
2016-11-18 minor fixes mr. hufschmid mentioned
    [amplifier-B.Cu.gbr, amplifier-B.Mask.gbr, amplifier-B.SilkS.gbr, amplifier-Edge.Cuts.gbr, amplifier-F.Cu.gbr, amplifier-F.Mask.gbr, amplifier-F.SilkS.gbr, amplifier-NPTH.drl]
2016-11-29 Duplicated amp schematics for version1 so version2 can be edited already; added jupyter nb for measuring and evaluation; added pdf for bom; added arduino software to speak to dac
    [amplifier-B.Cu.gbr, amplifier-B.Mask.gbr, amplifier-B.SilkS.gbr, amplifier-Edge.Cuts.gbr, amplifier-F.Cu.gbr, amplifier-F.Mask.gbr, amplifier-F.SilkS.gbr, amplifier-NPTH.drl]
2016-12-01 added smith charts explained; added new measurements & calcs; added script for arduino due
2016-12-15 added all measurementsa
    [C1DAC_level_12700000.csv, C2200kHz_LGA_inp00000.csv, C2input_1MHz00000.csv, C2inputllo0.5v00000.csv, C2lga_inputllo0.5v00000.csv, C2nodac_intput_1MHz00000.csv, C3200kHz_LGA00000.csv, C3lga_outputlo0.5v00000.csv]
2016-12-15 added calibration routines (untested)
2016-12-15 Automatic loading and storing of calibrations
2016-12-15 Made classes for measurement devices
2016-12-16 Implemented power setup and single shot; untested
2016-12-16 Configuring works thus far except for calibration storing 'Invalid separator' error on vna ...
    [E5071B.py, PL303.py, measure.py]
2016-12-16 added measurement data from 2016-12-16
    [reading 0.04.csv, reading 0.05.csv, reading 0.06.csv, reading 0.07.csv, reading 0.08.csv, reading 0.09.csv, reading 0.1.csv, reading 0.11.csv]
2016-12-17 Calcs on first measurements
    [reading_reflection_0.04.csv, reading_reflection_0.05.csv, reading_reflection_0.06.csv, reading_reflection_0.07.csv, reading_reflection_0.08.csv, reading_reflection_0.09.csv, reading_reflection_0.1.csv, reading_reflection_0.10.csv]
2016-12-19 measurement script now supports specifying a measurement location; also fixed the bug with the fienames lacking an 0; measured some stuff with higher resolution
    [reading_reflection_0.04.csv, reading_reflection_0.05.csv, reading_reflection_0.06.csv, reading_reflection_0.07.csv, reading_reflection_0.08.csv, reading_reflection_0.09.csv, reading_reflection_0.1.csv, reading_reflection_0.11.csv]
2016-12-19 changed broken filenames
    [reading_reflection_0.10.csv, reading_reflection_0.20.csv, reading_reflection_0.30.csv, reading_reflection_0.40.csv, reading_reflection_0.50.csv, reading_reflection_0.60.csv, reading_reflection_0.70.csv, reading_reflection_0.80.csv]
2016-12-23 cleanup and addition of Pretty- files
    [C1DAC_level_12700000.csv, C2200kHz_LGA_inp00000.csv, C2input_1MHz00000.csv, C2inputllo0.5v00000.csv, C2lga_inputllo0.5v00000.csv, C2nodac_intput_1MHz00000.csv, C3200kHz_LGA00000.csv, C3lga_outputlo0.5v00000.csv]
2017-01-13 ground layout img done
    [amplifier.kicad_pcb]
2017-01-15 work on mesurements section; drawn circuit with tikz yay!
2017-01-15 nearly done documenting measurements
    [reading_reflection_0.04.csv, reading_reflection_0.05.csv, reading_reflection_0.06.csv, reading_reflection_0.07.csv, reading_reflection_0.08.csv, reading_reflection_0.09.csv, reading_reflection_0.10.csv, reading_reflection_0.11.csv]
2017-01-17 described measuring devices
2017-01-18 Remove borked files
    [C1DAC_level_12700000.csv, C2200kHz_LGA_inp00000.csv, C2input_1MHz00000.csv, C2inputllo0.5v00000.csv, C2lga_inputllo0.5v00000.csv, C2nodac_intput_1MHz00000.csv, C3200kHz_LGA00000.csv, C3lga_outputlo0.5v00000.csv]
2017-01-18 Re-add files, hopefully fixing them
    [C1DAC_level_12700000.csv, C2200kHz_LGA_inp00000.csv, C2input_1MHz00000.csv, C2inputllo0.5v00000.csv, C2lga_inputllo0.5v00000.csv, C2nodac_intput_1MHz00000.csv, C3200kHz_LGA00000.csv, C3lga_outputlo0.5v00000.csv]
2017-01-18 measured a ton of the fixed PCB
    [reading_transmission_0.04.csv, reading_transmission_0.05.csv, reading_transmission_0.06.csv, reading_transmission_0.07.csv, reading_transmission_0.08.csv, reading_transmission_0.09.csv, reading_transmission_0.10.csv, reading_transmission_0.11.csv]
2017-01-18 Added newest plots for last measurements
    [reading_transmission_0.04.csv, reading_transmission_0.05.csv, reading_transmission_0.06.csv, reading_transmission_0.07.csv, reading_transmission_0.08.csv, reading_transmission_0.09.csv, reading_transmission_0.10.csv, reading_transmission_0.11.csv]
2017-01-19 beautified and corrected bom; added aufgabenstellung; added both to report
    [amplifier.sch, bom-prototype.xlsx]
2017-01-19 track pifilter sim
2017-01-19 beautified projektplan; added it to report
    [tasks.xlsx]
2017-01-19 fixed wrong footprint
    [amplifier.kicad_pcb]
2017-01-19 Track remaining ltspice sim files and result from sim
2017-01-19 fixed wrong numbering on filter stuff; plotted filter measurements/sim
    [LOWPASS300K-300M-CONNECTED.CSV, LOWPASS300K-300M-DISCONNECTED.CSV, LOWPASS300K-3G-CONNECTED.CSV, LOWPASS300K-3G-DISCONNECTED.CSV, TRACE01.CSV, TRACE02.CSV, TRACE03.CSV, reading 0.04.csv]
2017-01-19 Created filter section and included power filter
2017-01-19 Some filter text
2017-01-20 tikzed AFE filter
2017-01-20 added adc and fpga to blockfiagram
2017-01-20 tikzed pi filter
2017-01-20 update with new graphics, small changes in filter
2017-01-20 split filter chapter
2017-01-20 Small grammar fixes, removed hyperlative, corrected page/graphics flow
